yeffrimic/water-Quality-Station/README.md

# water-Quality-Station
This is a repo with all the documentation to create, replicate and improve the quality water station from sincyt project
