yeffrimic/water-Quality-Station/water quality/custom/DM-OLED096-636.step

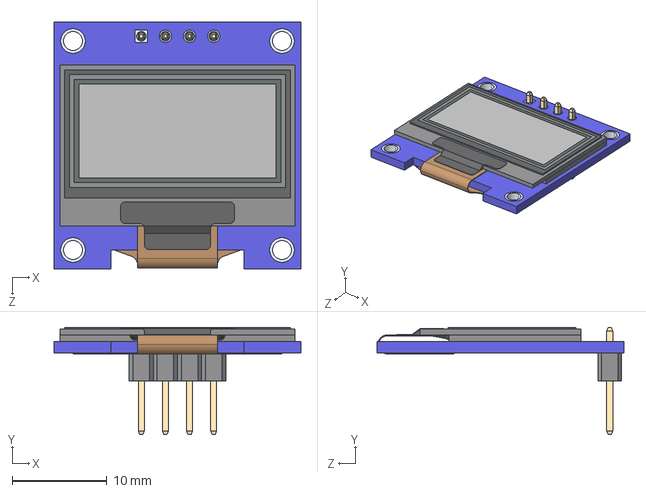
[picture p1: CAD file, 2024-04-30]
water quality/custom/DM-OLED096-636.step
26.0 x 11.3 x 26.0 mm
DM-OLED096-636_Module
DM-OLED096-636_Panel
