yeffrimic/water-Quality-Station/water quality/water quality.kicad_pcb

## KiCad design water quality/water quality.kicad_pcb (2024-04-30)

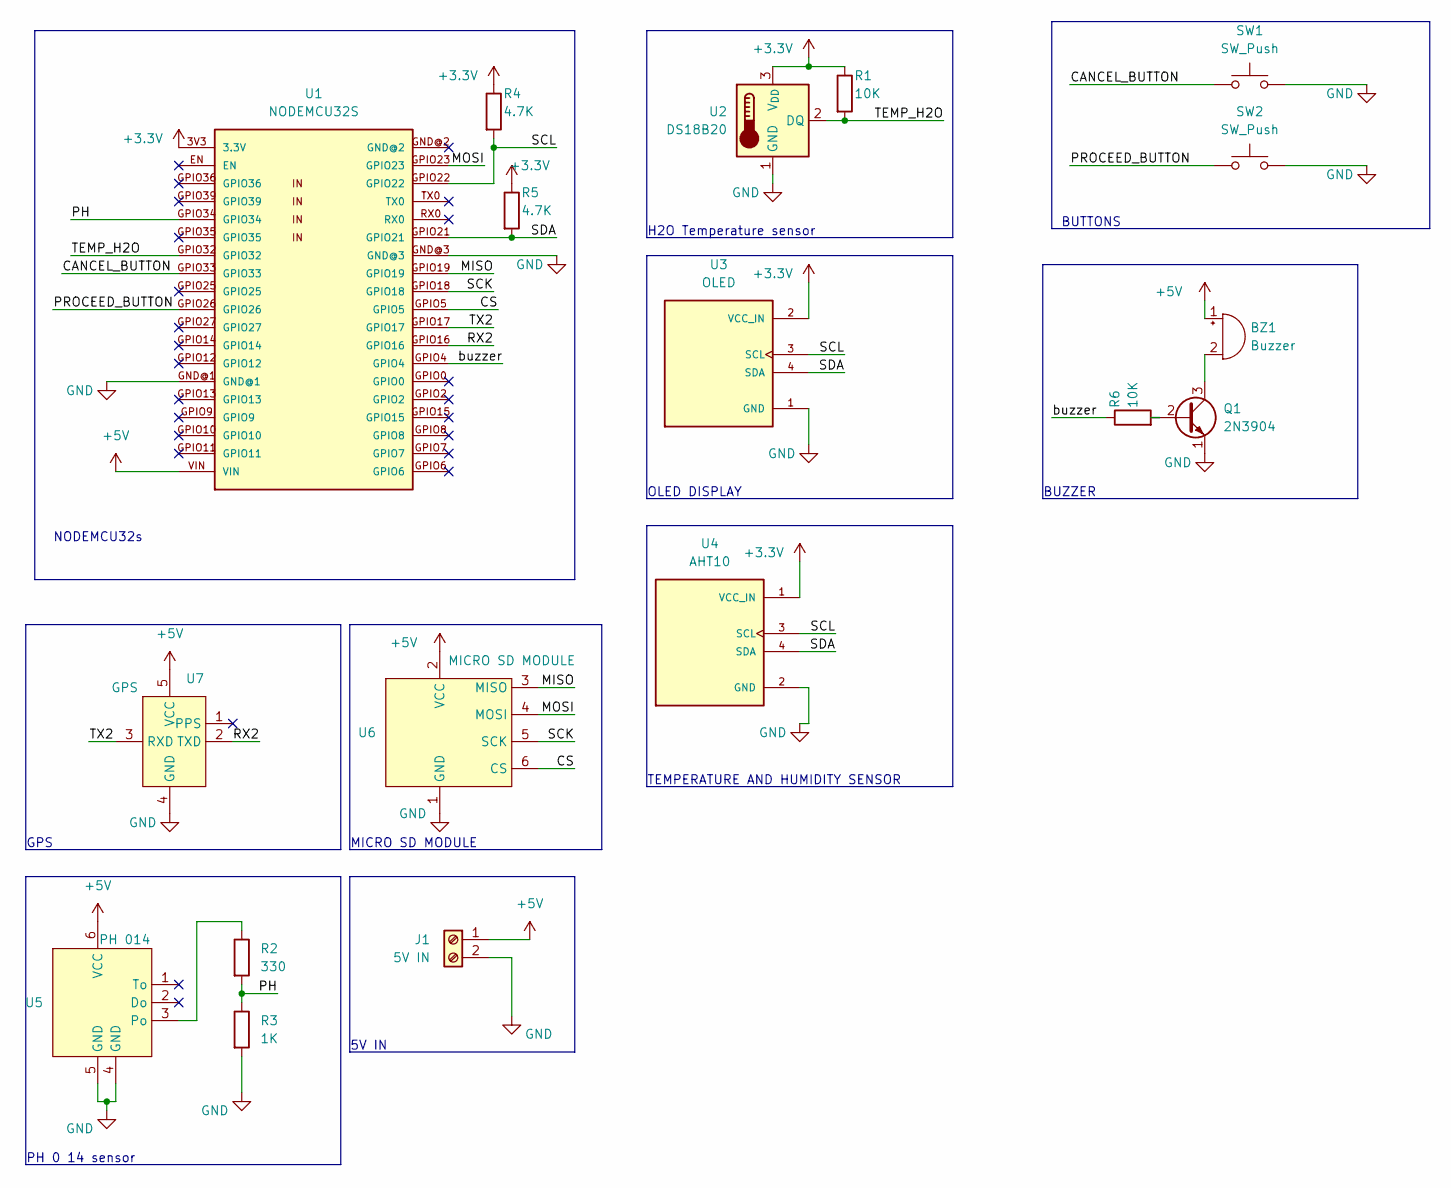
[picture p2: schematic water quality.kicad_sch]

Parts:
BZ1: Buzzer; Buzzer_12x9.5RM7.6
J1: 5V IN
Q1: 2N3904; TO-92_Inline
R1, R6: 10K; R_Axial_DIN0207_L6.3mm_D2.5mm_P10.16mm_Horizontal
R2: 330; R_Axial_DIN0207_L6.3mm_D2.5mm_P10.16mm_Horizontal
R3: 1K; R_Axial_DIN0207_L6.3mm_D2.5mm_P10.16mm_Horizontal
R4, R5: 4.7K; R_Axial_DIN0207_L6.3mm_D2.5mm_P10.16mm_Horizontal
SW1, SW2: SW_Push; SW_PUSH_6mm
U1: NODEMCU32S
U2: DS18B20; TerminalBlock_bornier-3_P5.08mm
U3: OLED; MODULE_DM-OLED096-636; PARTREV 2018-09-10
U4: AHT10; aht10; PARTREV 2018-09-10
U5: PH 014; ph sensor
U6: MICRO SD MODULE
U7: GPS; GPS neo6vm

Connections:
+3.3V: R1.1, R4.1, R5.1, U1.3V3 (3.3V), U2.3 (V_{DD}), U3.2 (VCC_IN), U4.1 (VCC_IN)
+5V: BZ1.1 (+), J1.1, U1.VIN, U5.6 (VCC), U6.2 (VCC), U7.5 (VCC)
/CANCEL_BUTTON: SW1.1, U1.GPIO33
/CS: U1.GPIO5, U6.6 (CS)
/MISO: U1.GPIO19, U6.3 (MISO)
/MOSI: U1.GPIO23, U6.4 (MOSI)
/PH: R2.2, R3.1, U1.GPIO34
/PROCEED_BUTTON: SW2.1, U1.GPIO26
/RX2: U1.GPIO16, U7.2 (TXD)
/SCK: U1.GPIO18, U6.5 (SCK)
/SCL: R4.2, U1.GPIO22, U3.3 (SCL), U4.3 (SCL)
/SDA: R5.2, U1.GPIO21, U3.4 (SDA), U4.4 (SDA)
/TEMP_H2O: R1.2, U1.GPIO32, U2.2 (DQ)
/TX2: U1.GPIO17, U7.3 (RXD)
/buzzer: R6.1, U1.GPIO4
GND: J1.2, Q1.1 (E), R3.2, SW1.2, SW2.2, U1.GND@1, U1.GND@3, U2.1 (GND), U3.1 (GND), U4.2 (GND), U5.4 (GND), U5.5 (GND), U6.1 (GND), U7.4 (GND)
unnamed: BZ1.2 (-), Q1.3 (C)
unnamed: Q1.2 (B), R6.2
unnamed: R2.1, U5.3 (Po)

Notes on the sheet:
5V IN
BUZZER
PH 0 14 sensor
OLED DISPLAY
H2O Temperature sensor
NODEMCU32s
MICRO SD MODULE
BUTTONS
TEMPERATURE AND HUMIDITY SENSOR
GPS

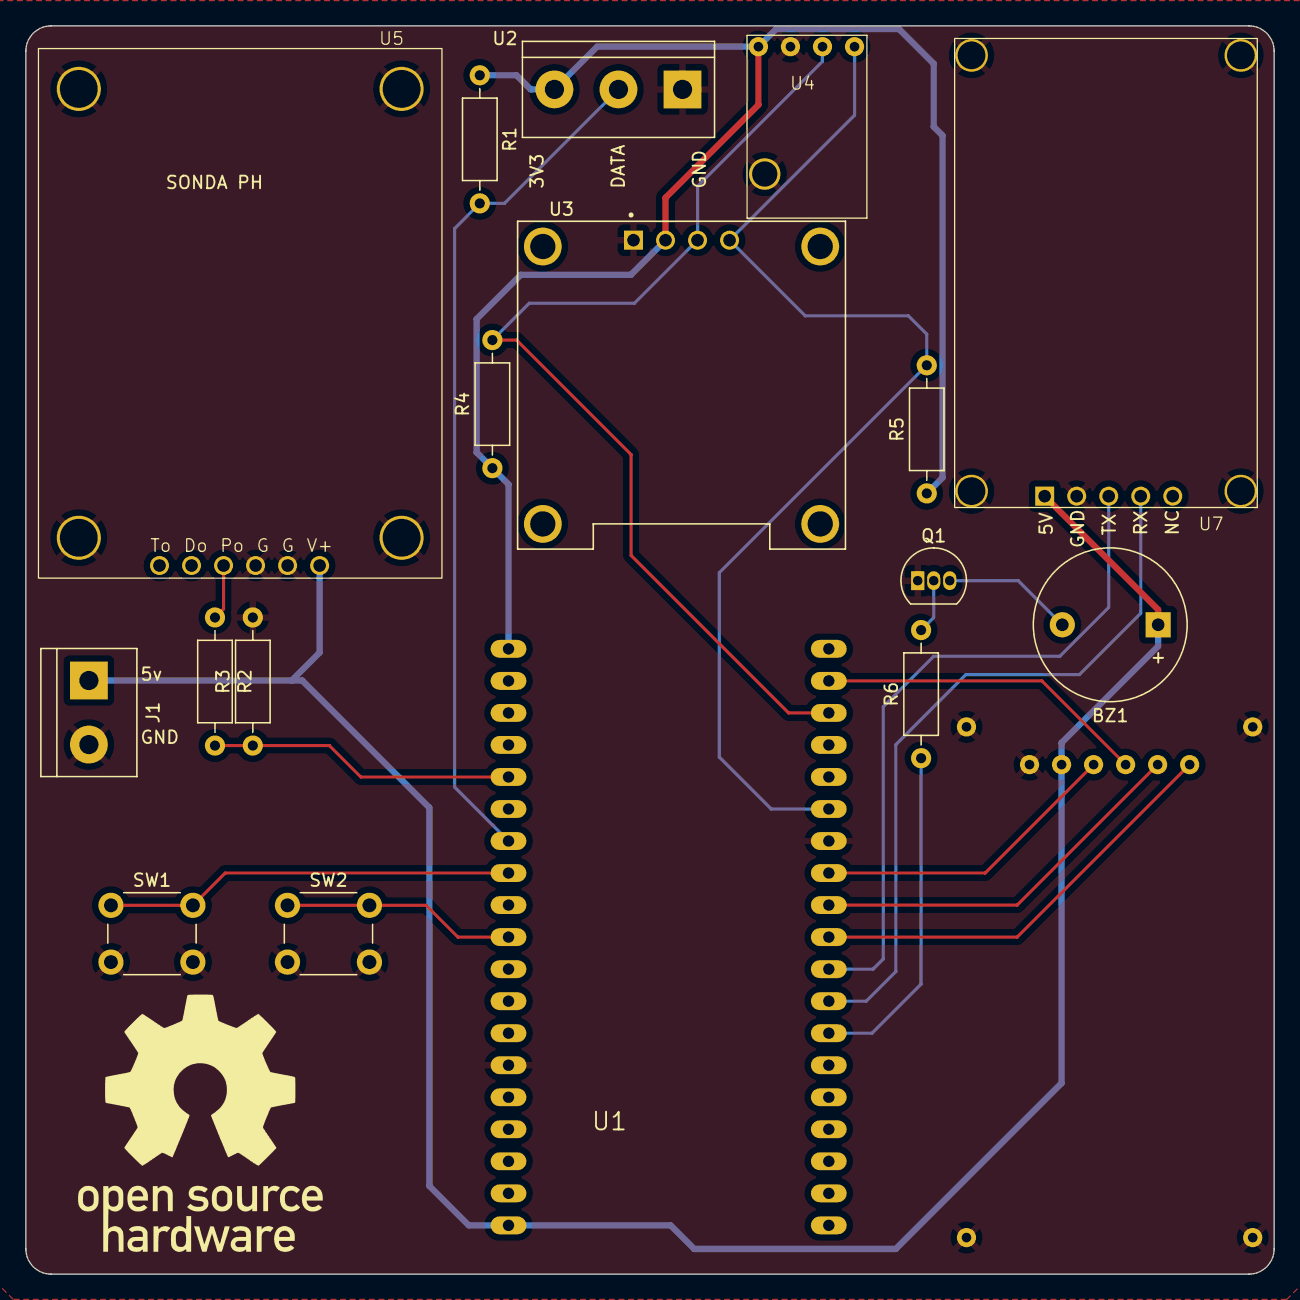
[picture p3: board water quality.kicad_pcb from above]

Board: 4 copper layers, 99.0 x 99.0 mm, 18 parts (1 on the bottom side), 19 nets.
