yeffrimic/water-Quality-Station/(commit log)

2024-04-30 add kicad files
    [DM-OLED096-636.step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]
2026-07-31 screen model fix, aesthetic changes, mqtt chanel change
    [code.ino]
2026-07-31 Added init screen with countdown timer and error screen when there is not wifi and gps
    [code.ino]
2026-07-31 transmition button logic changed to start and stop, incrementing the sessionId on each start. data is sent on start to mqtt or file if there is not connection, if there is connection the queue will b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
    [code.ino]
2026-07-31 the other button will now cycle screens between data, pendig messages to send, and wifi instructions
2026-07-31 Fixed button variable names to include the letter printed on the device case
    [code.ino]
2026-07-31 fix on string length for connection instructions screen
    [code.ino]
2026-07-31 fixes to ensure to have the mac adress
    [code.ino]
2026-07-31 improvements in water temp readings to do not block the device
2026-07-31 Added a check on ph values to avoid faulty data
    [code.ino]
2026-08-01 fixed bug where when data was stored to mem, it was sending mac with \r
    [code.ino]
